LinusFonseca/TCC_LINUS/README.md

# TCC_LINUS

Control System Application developed to control and monitore Home-brewing process. It was part of final graduation project of Electric Engeneering Major. The System comunicate via serial comunication with Arduino Uno. Uno act on relays to trigger valvs and pumps. Also control servomotors controling the butane regulator that heats the must. 
# States Machine
The Control System runs in a state machine logic. Where each state refers to a different time/step of the process and different output.
