LinusFonseca/TCC_LINUS/TCC_01_Control_System/centrifuga.gif

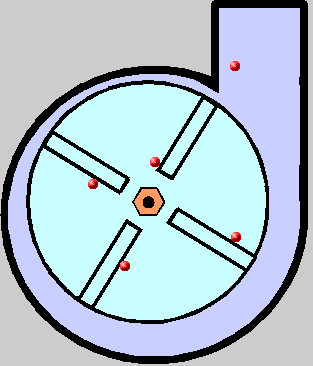
TCC_01_Control_System/centrifuga.gif
