LinusFonseca/TCC_LINUS/TCC_01_Control_System/Centrifuga.png

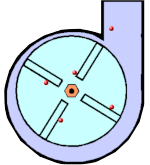
TCC_01_Control_System/Centrifuga.png
