LinusFonseca/TCC_LINUS/TCC_01_Control_System/estado-fisico-fogo.png

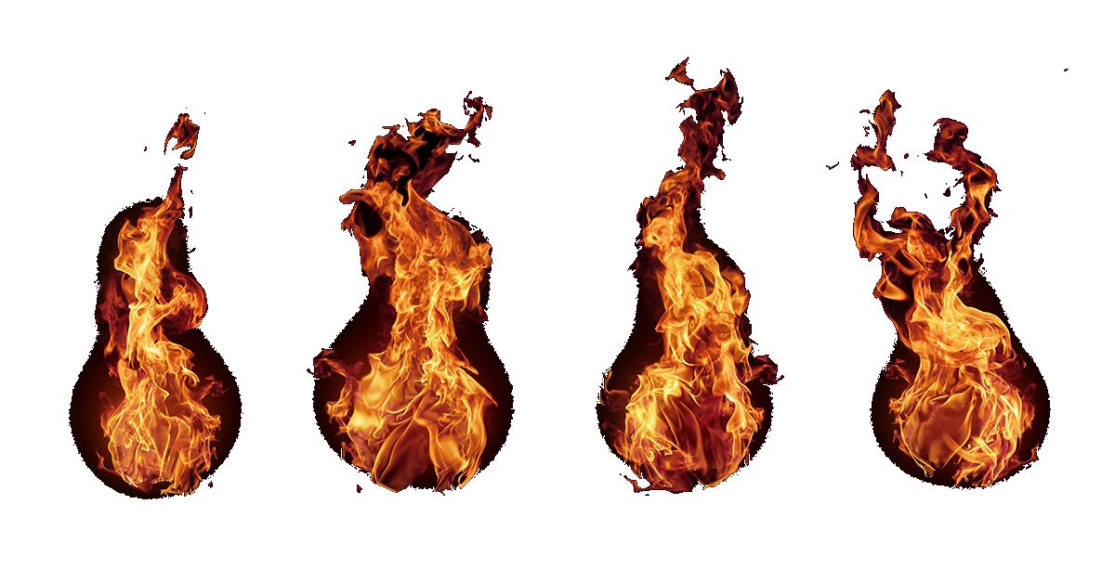
TCC_01_Control_System/estado-fisico-fogo.png
