LinusFonseca/TCC_LINUS/TCC_01_Control_System/PanelaCheia.png

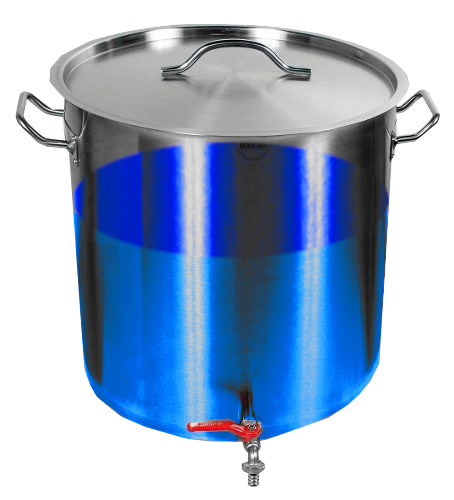
TCC_01_Control_System/PanelaCheia.png
