LinusFonseca/TCC_LINUS/TCC_01_Control_System/SolenoideRED - Copy.png

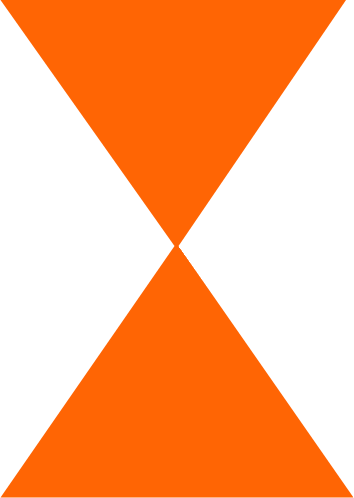
TCC_01_Control_System/SolenoideRED - Copy.png
