LinusFonseca/TCC_LINUS/TCC_01_Control_System/SolenoideRED.png

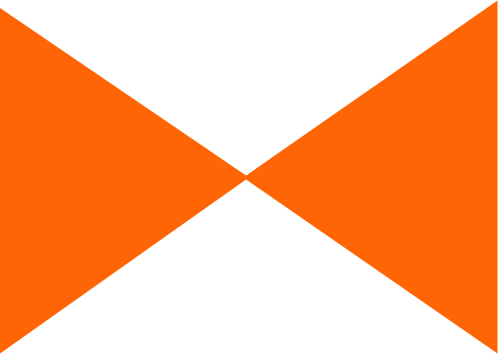
TCC_01_Control_System/SolenoideRED.png
