LinusFonseca/TCC_LINUS/Text_Latex/img/acaoenzimatica.jpg

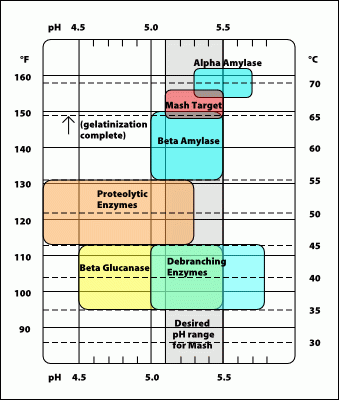
Text_Latex/img/acaoenzimatica.jpg
