LinusFonseca/TCC_LINUS/Text_Latex/img/brewstand.png

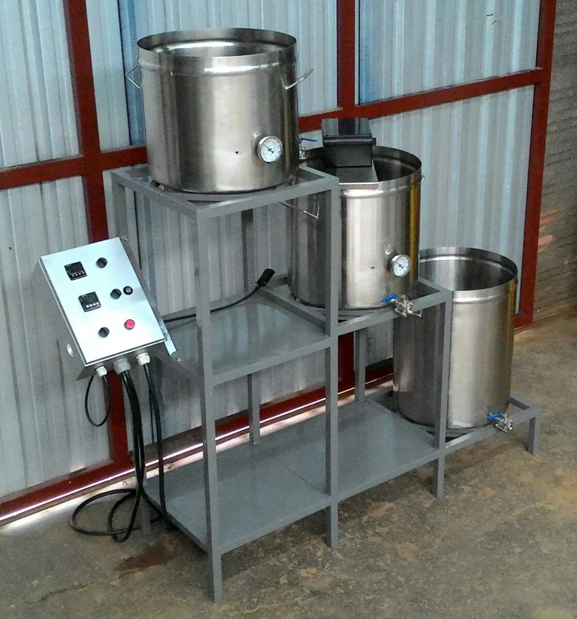
Text_Latex/img/brewstand.png
