LinusFonseca/TCC_LINUS/Text_Latex/img/f89.png

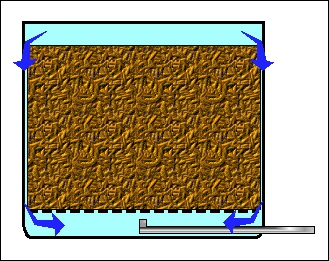
Text_Latex/img/f89.png
