LinusFonseca/TCC_LINUS/Text_Latex/img/RedePetri.png

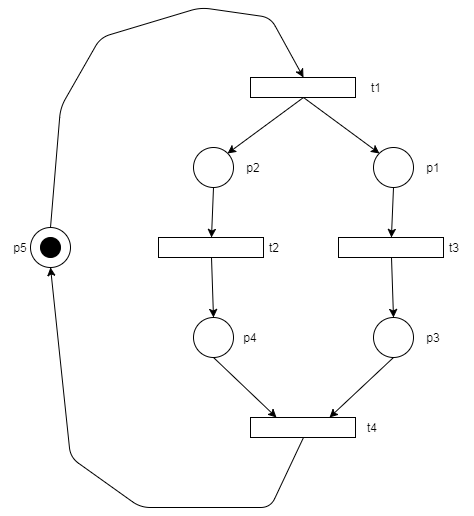
Text_Latex/img/RedePetri.png
