LinusFonseca/TCC_LINUS/Text_Latex/img/TCCblockdiagram.png

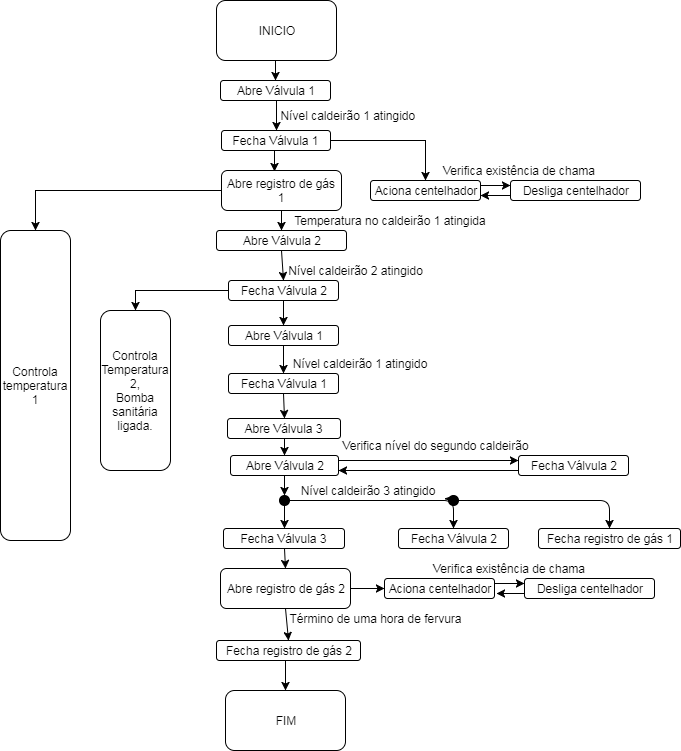
Text_Latex/img/TCCblockdiagram.png
