LinusFonseca/TCC_LINUS/Text_Latex/img/ImagemTeste01.png

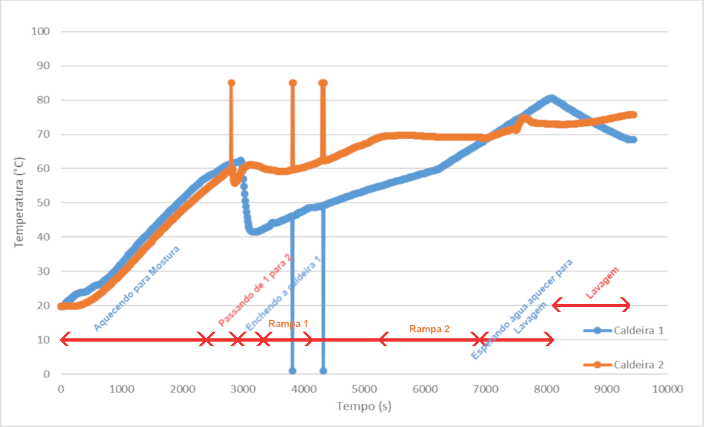
Text_Latex/img/ImagemTeste01.png
