LinusFonseca/TCC_LINUS/Text_Latex/img/ImagemTeste06.jpg

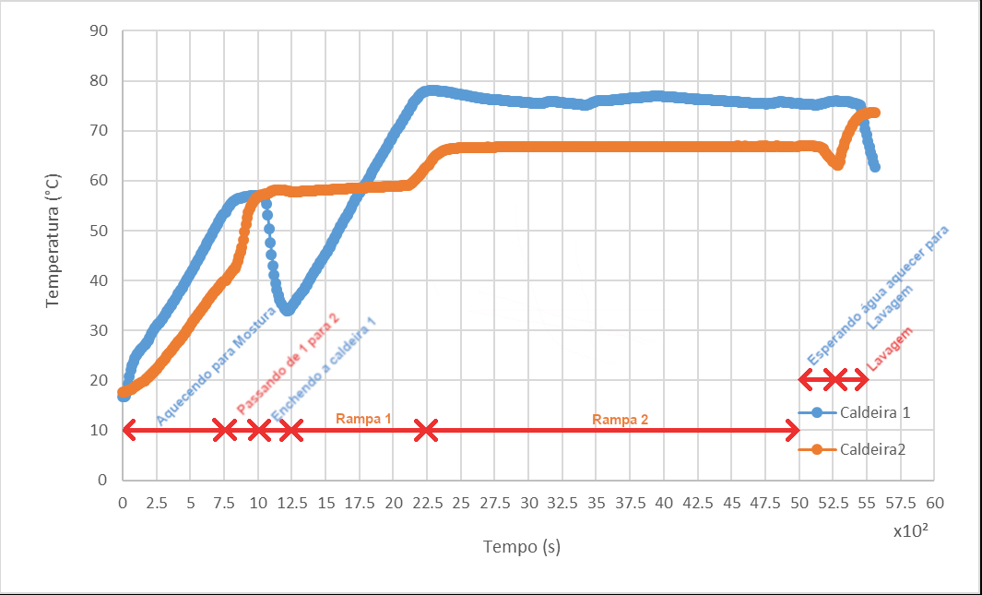
Text_Latex/img/ImagemTeste06.jpg
