LinusFonseca/TCC_LINUS/Text_Latex/img/ImagemTeste07.png

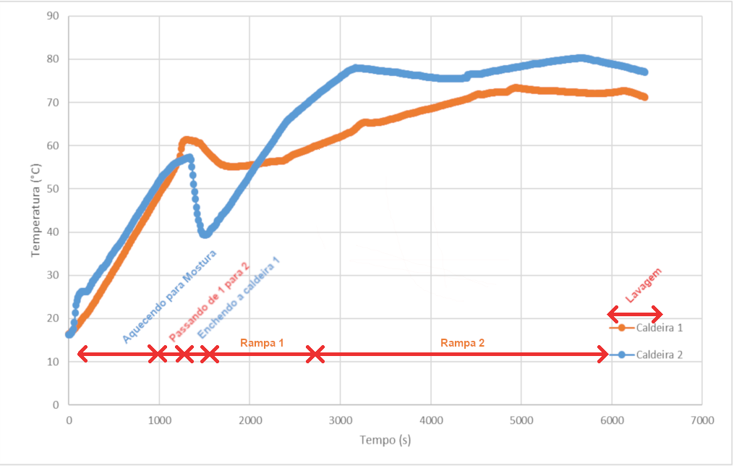
Text_Latex/img/ImagemTeste07.png
