LinusFonseca/TCC_LINUS/Text_Latex/img/Teste01Temperatura.JPG

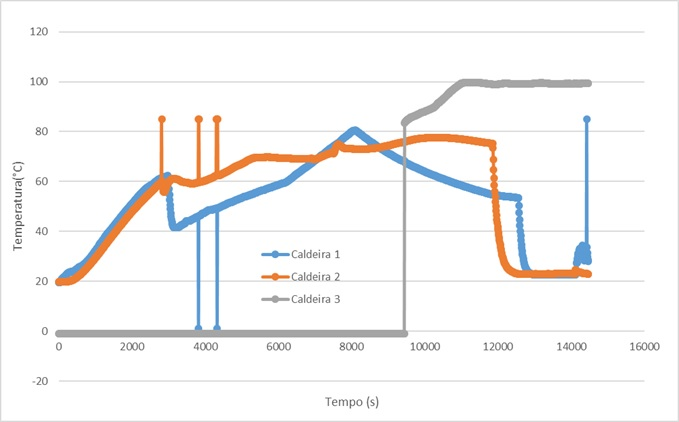
Text_Latex/img/Teste01Temperatura.JPG
